zhangjinke/jlink_wifi_v831_hardware/Photos/IMG_20230429_182352.jpg

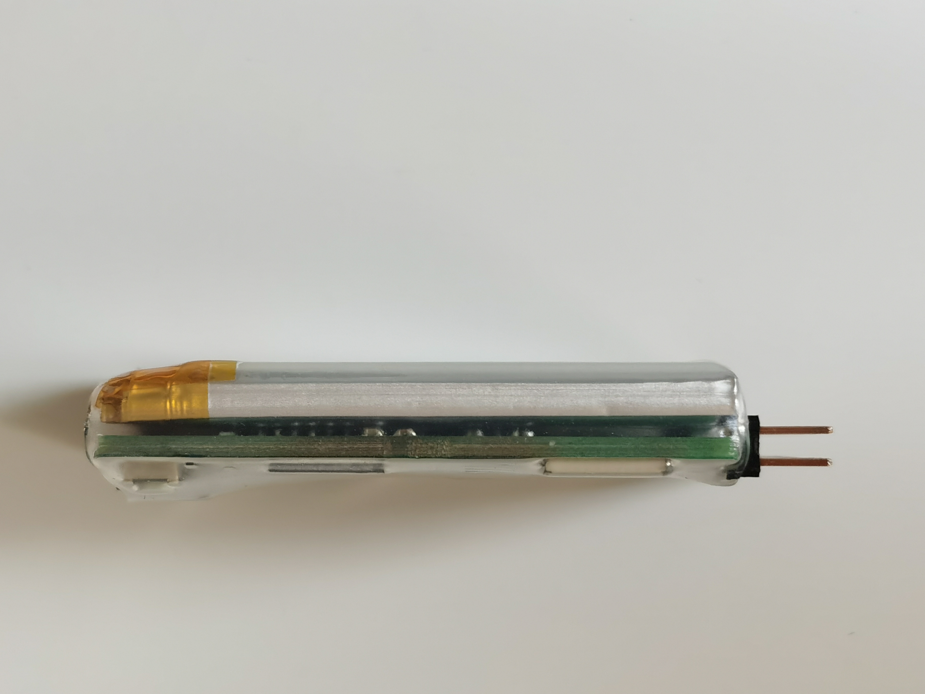
Photos/IMG_20230429_182352.jpg
