zhangjinke/jlink_wifi_v831_hardware/PCB/说明.txt

工程使用嘉立创EDA(专业版)创建

层压顺序：JLC04161H-7628(通用推荐/免费)结构
阻抗管控：+/-20%（免费）
电池型号：053048
热缩管直径：Φ25mm
热缩管长度：54mm
