zhangjinke/jlink_wifi_v831_hardware/PCB/BOM_J-Link_WiFi_072_V831_J-Link_WiFi_072_V831_2023-10-15.xlsx

No. | Quantity | Comment | Designator | Footprint | Value | Manufacturer Part | Manufacturer | Primary Category | Secondary Category | LCSC Price | Price | 总价
1 | 19 | 2.2uF | C1,C2,C5,C6,C7,C8,C9,C10,C11,C12,C23,C27,C35,C36,C37,C40,C41,C42,C50 | C0402 | 2.2uF | CL05A225MQ5NNNC | SAMSUNG(三星) | Capacitors | Multilayer Ceramic Capacitors MLCC - SMD/SMT | 0.027553 | 0.523507 | 83.577195
2 | 5 | 10uF | C3,C4,C22,C34,C45 | C0402 | 10uF | CL05A106MQ5NUNC | SAMSUNG(三星) | Capacitors | Multilayer Ceramic Capacitors MLCC - SMD/SMT | 0.029753 | 0.148765
3 | 15 | 100nF | C13,C24,C28,C29,C30,C32,C33,C52,C53,C57,C58,C59,C60,C61,C62 | C0402 | 100nF | CC0402KRX7R8BB104 | YAGEO(国巨) | Capacitors | Multilayer Ceramic Capacitors MLCC - SMD/SMT | 0.011655 | 0.174825
4 | 4 | 4.7uF | C14,C15,C16,C55 | C0402 | 4.7uF | CL05A475MQ5NRNC | SAMSUNG(三星) | Capacitors,电容 | Multilayer Ceramic Capacitors MLCC - SMD/SMT,贴片电容(MLCC) | 0.021606 | 0.086424
5 | 4 | 22uF | C17,C18,C19,C20 | C0603 | 22uF | CL10A226MQ8NRNE | SAMSUNG(三星) | Capacitors | Multilayer Ceramic Capacitors MLCC - SMD/SMT | 0.065411 | 0.261644
6 | 2 | 20pF | C21,C26 | C0402 | 20pF | CC0402JRNPO9BN200 | YAGEO(国巨) | Capacitors | Multilayer Ceramic Capacitors MLCC - SMD/SMT | 0.006429 | 0.012858
7 | 1 | 10nF | C25 | C0402 | 10nF | CC0402KRX7R9BB103 | YAGEO(国巨) | Capacitors | Multilayer Ceramic Capacitors MLCC - SMD/SMT | 0.005007 | 0.005007
8 | 3 | 1nF | C31,C38,C39 | C0402 | 1nF | CC0402KRX7R7BB102 | YAGEO(国巨) | Capacitors | Multilayer Ceramic Capacitors MLCC - SMD/SMT | 0.006444 | 0.019332
9 | 4 | 470nF | C43,C44,C49,C51 | C0402 | 470nF | CL05A474KP5NNNC | SAMSUNG(三星) | Capacitors | Multilayer Ceramic Capacitors MLCC - SMD/SMT | 0.020612 | 0.082448
10 | 1 | 5.6pF | C46 | C0402 | 5.6pF | CL05C5R6CB5NNNC | SAMSUNG(三星) | 电容 | 贴片电容(MLCC) | 0.024957 | 0.024957
11 | 2 | 1uF | C47,C48 | C0402 | 1uF | CC0402KRX5R5BB105 | YAGEO(国巨) | Capacitors | Multilayer Ceramic Capacitors MLCC - SMD/SMT | 0.014371 | 0.028742
12 | 2 | TBD | C54,C56 | C0402 | TBD
13 | 7 | PESDHC2FD4V5BH | D1,D3,D4,D5,D6,D7,D8 | DFN1006-2L-BI |  | PESDHC2FD4V5BH | Prisemi 芯导 | TVS/Fuse/Board Level Protection | ESD Protection Devices | 0.104758 | 0.733306
14 | 1 | 1N5819WS | D2 | SOD-323_L1.6-W1.3-LS2.6-RD-1 |  | 1N5819WS | GOODWORK(固得沃克) | Diodes | Schottky Barrier Diodes (SBD) | 0.087668 | 0.087668
15 | 4 | 1uH | L1,L2,L3,L4 | IND-SMD_L2.5-W2.0_AHP252010X | 1uH | SWPA252012S1R0MT | Sunlord(顺络) | Inductors/Coils/Transformers | Power Inductors | 0.259522 | 1.038088
16 | 1 | 2.2uH | L5 | IND-SMD_L2.5-W2.0_AHP252010X | 2.2uH | SWPA252010S2R2MT | Sunlord(顺络) | 电感/线圈/变压器 | 功率电感 | 0.245798 | 0.245798
17 | 1 | TBD | L6 | L0201 | TBD
18 | 1 | AN9520-245 | L7 | ANT-SMD_L9.5-W2.1 |  | AN9520-245 | rainsun台湾霖昱微 | Radio Frequency Chip/Antenna | Antennas | 1.8521 | 1.8521
19 | 3 | RED | LED1,LED3,LED4 | LED0402-RD |  | MHT136CRCT | MEIHUA(美华科技) | Optocoupler/LED/Digital Tube/Photoelectric Device | Light Emitting Diodes (LED) | 0.2472 | 0.7416
20 | 1 | GREEN | LED2 | LED0402-RD_GREEN |  | MHT136CGCT | MEIHUA(美华科技) | Optocoupler/LED/Digital Tube/Photoelectric Device | Light Emitting Diodes (LED) | 0.24338 | 0.24338
21 | 1 | WHITE | LED5 | LED0402-RD_WHITE |  | MHT136WDT-C2 | MEIHUA(美华科技) | Optocoupler/LED/Digital Tube/Photoelectric Device | Light Emitting Diodes (LED) | 0.300103 | 0.300103
22 | 1 | BLUE | LED6 | LED0402-RD_BLUE |  | MHT136UBCT | MEIHUA(美华科技) | Optocoupler/LED/Digital Tube/Photoelectric Device | Light Emitting Diodes (LED) | 0.264358 | 0.264358
23 | 1 | YELLOW | LED7 | LED0402-RD_YELLOW |  | MHT136CYCT | MEIHUA(美华科技) | Optocoupler/LED/Digital Tube/Photoelectric Device | Light Emitting Diodes (LED) | 0.268196 | 0.268196
24 | 1 | BAT | P1 | HDR-TH_2P-P1.27-V-M |  | 1.27-1*2P针 | BOOMELE(博穆精密) | Connectors | Pin Headers | 0.108128 | 0.108128
25 | 1 | DEBUG | P2 | HDR-TH_3P-P1.27-V-M-1 |  | 1.27-1*3P针 | BOOMELE(博穆精密) | Connectors | Pin Headers | 0.164047 | 0.164047
26 | 1 | SWD | P3 | HDR-TH_4P-P1.27-V-M |  | DZ127R-11-04-25 | DEALON(德艺隆) | Connectors | Pin Headers | 0.149906 | 0.149906
27 | 1 | PORT | P4 | HDR-SMD_20P-P2.54 |  | B-2100S20P-B110 | Ckmtw(灿科盟) | 连接器 | 排针 | 1.0931 | 1.0931
28 | 3 | 2.2kΩ | R1,R2,R6 | R0402 | 2.2kΩ | 0402WGF2201TCE | UNI-ROYAL(厚声) | Resistors | Chip Resistor - Surface Mount | 0.003099 | 0.009297
29 | 6 | 4.7kΩ | R3,R10,R11,R22,R31,R32 | R0402 | 4.7kΩ | RC0402FR-074K7L | YAGEO(国巨) | Resistors | Chip Resistor - Surface Mount | 0.003681 | 0.022086
30 | 1 | SDNT1608X103F3435FTF | R4 | R0603 |  | SDNT1608X103F3435FTF | Sunlord(顺络) | Sensors | NTC Thermistors | 0.133355 | 0.133355
31 | 2 | 680Ω | R5,R23 | R0402 | 680Ω | 0402WGF6800TCE | UNI-ROYAL(厚声) | Resistors | Chip Resistor - Surface Mount | 0.003059 | 0.006118
32 | 2 | 33Ω | R7,R8 | R0402 | 33Ω | 0402WGF330JTCE | UNI-ROYAL(厚声) | Resistors | Chip Resistor - Surface Mount | 0.003032 | 0.006064
33 | 2 | 0Ω | R9,R12 | R0402 | 0Ω | AC0402FR-070RL | YAGEO(国巨) | Resistors | Chip Resistor - Surface Mount | 0.006307 | 0.012614
34 | 5 | 33kΩ | R13,R14,R15,R16,R17 | R0402 | 33kΩ | 0402WGF3302TCE | UNI-ROYAL(厚声) | 电阻 | 贴片电阻 | 0.003037 | 0.015185
35 | 2 | 5.1kΩ | R18,R20 | R0402 | 5.1kΩ | RC0402FR-075K1L | YAGEO(国巨) | Resistors | Chip Resistor - Surface Mount | 0.003718 | 0.007436
36 | 2 | 100kΩ | R19,R21 | R0402 | 100kΩ | AC0402FR-07100KL | YAGEO(国巨) | Resistors | Chip Resistor - Surface Mount | 0.006564 | 0.013128
37 | 5 | 100Ω | R24,R25,R26,R29,R30 | R0402 | 100Ω | RC0402FR-07100RL | YAGEO(国巨) | Resistors | Chip Resistor - Surface Mount | 0.003753 | 0.018765
38 | 2 | 27Ω | R27,R28 | R0402 | 27Ω | RTT0227R0FTH | RALEC(旺诠) | Resistors | Chip Resistor - Surface Mount | 0.008728 | 0.017456
39 | 2 | KEY | SW1,SW2 | SW-SMD_4P-L4.2-W3.3-P2.15-LS5.1 |  | TS-1089S-AR02516 | XUNPU(讯普) | Key/Switch | Tactile Switches | 0.334518 | 0.669036
40 | 1 | ME6206A33XG | U1 | SOT-23-3_L2.9-W1.6-P1.90-LS2.8-BR |  | ME6206A33XG | MICRONE(南京微盟) | 电源芯片 | 线性稳压器(LDO) | 0.25044 | 0.25044
41 | 1 | AXP2101 | U2 | QFN-40_L5.0-W5.0-P0.40-TL-EP3.4 |  | AXP2101 | Allwinner(全志) | PMIC |  | 5.48 | 5.48
42 | 1 | V831 | U3 | QFN-88_L9.0-W9.0-P0.35-TL-EP6.5 |  | V831 | Allwinner(全志) | MPU |  | 30.44 | 30.44
43 | 1 | CSNP1GCR01-BOW | U4 | LGA-8_L6.0-W8.0-P1.27-TL |  | CSNP1GCR01-BOW | CS(创世) | 存储器 | NAND FLASH | 10.45 | 10.45
44 | 1 | XR829 | U5 | QFN-40_L5.0-W5.0-P0.40-BL-EP3.4 |  | XR829 |  |  |  | 9.98 | 9.98
45 | 1 | SGM7222YMS10/TR | U6 | MSOP-10_L3.0-W3.0-P0.50-LS5.0-BL |  | SGM7222YMS10/TR | SGMICRO(圣邦微) | Communication Interface Chip/UART/485/232 | Analog Switches / Multiplexers | 5.36 | 5.36
46 | 1 | SMD0805B050TF | U7 | F0805 |  | SMD0805B050TF | Brightking(君耀电子) | TVS/保险丝/板级保护 | 自恢复保险丝 | 0.117108 | 0.117108
47 | 1 | SM05.TCT | U8 | SOT-23-3_L2.9-W1.3-P1.90-LS2.4 |  | SM05.TCT | UMW(友台半导体) | TVS/Fuse/Board Level Protection | ESD Protection Devices | 0.570952 | 0.570952
48 | 1 | MF-NSMF200-2 | U9 | F1206 |  | MF-NSMF200-2 | BOURNS | TVS/Fuse/Board Level Protection | Resettable Fuses | 0.165263 | 0.165263
49 | 1 | STM32F072CBT6 | U10 | LQFP-48_L7.0-W7.0-P0.50-LS9.0-BL |  | STM32F072CBT6 | ST(意法半导体) | Single Chip Microcomputer/Microcontroller | ST Microelectronics | 10.16 | 10.16
50 | 1 | KH-TYPE-C-16P | USB1 | USB-C-SMD_KH-TYPE-C-16P |  | KH-TYPE-C-16P | kinghelm(金航标) | Connectors | USB Connectors | 0.511 | 0.511
51 | 1 | 24MHz | X1 | CRYSTAL-SMD_4P-L2.0-W1.6-BL | 24MHz | X201624MKB4SI | YXC(扬兴科技) | Crystal Oscillator/Oscillator/Resonator | Crystals | 0.503605 | 0.503605
