zhangjinke/jlink_wifi_v831_hardware/PCB/SCH_J-Link_WiFi_072_V831_2023-09-08.pdf

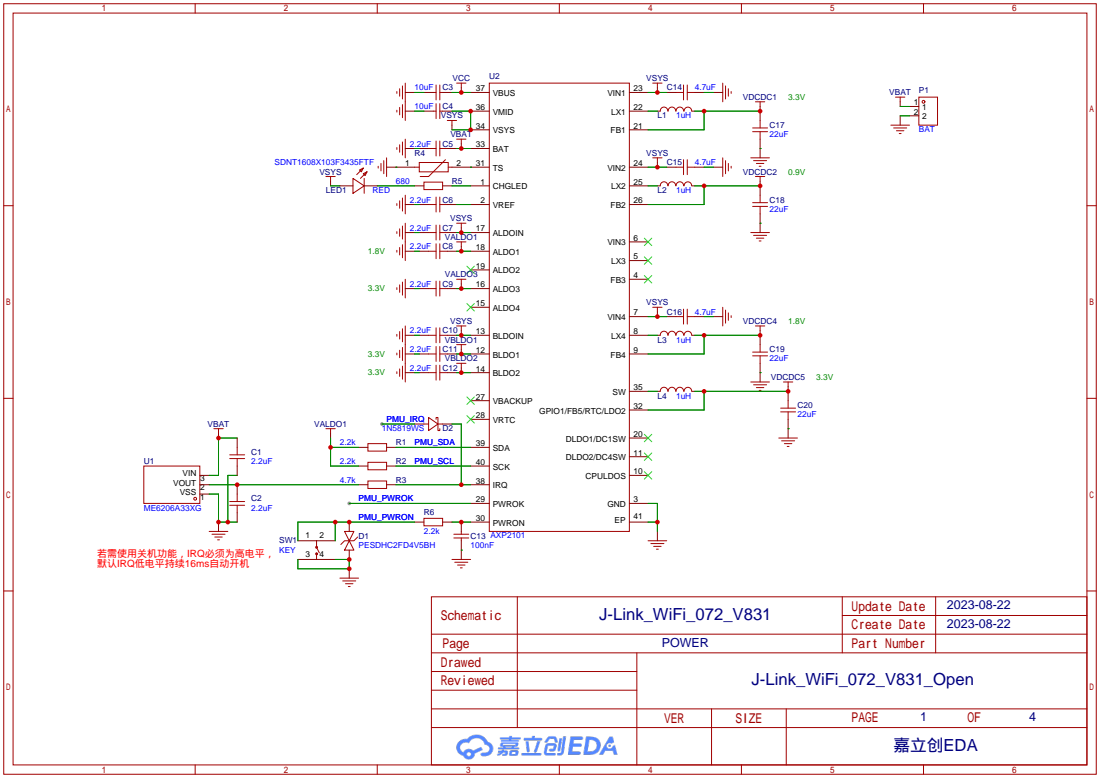
[picture p4: page 1]

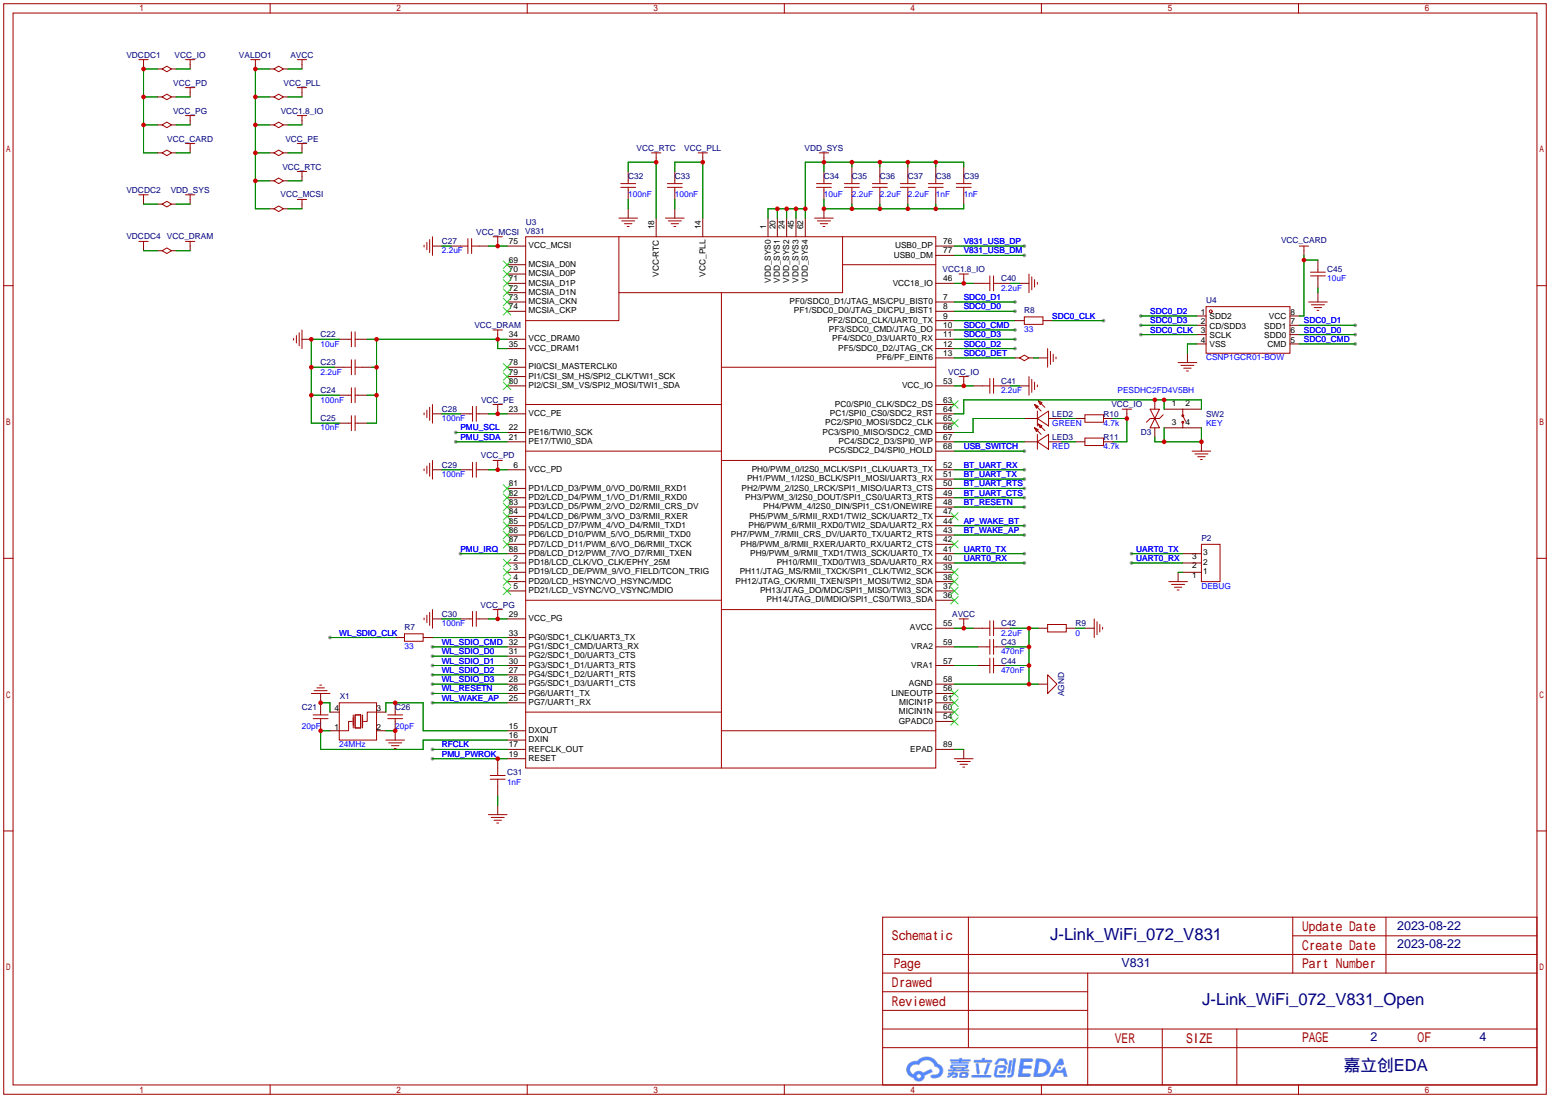
[picture p5: page 2]

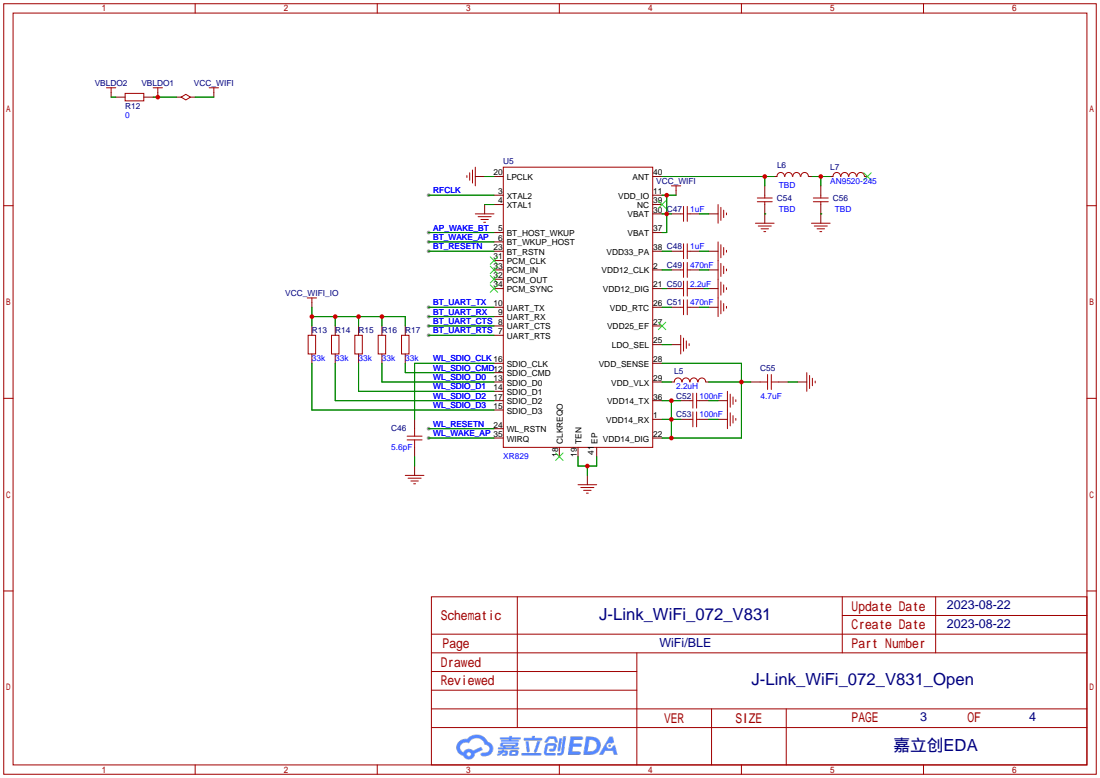
[picture p6: page 3]

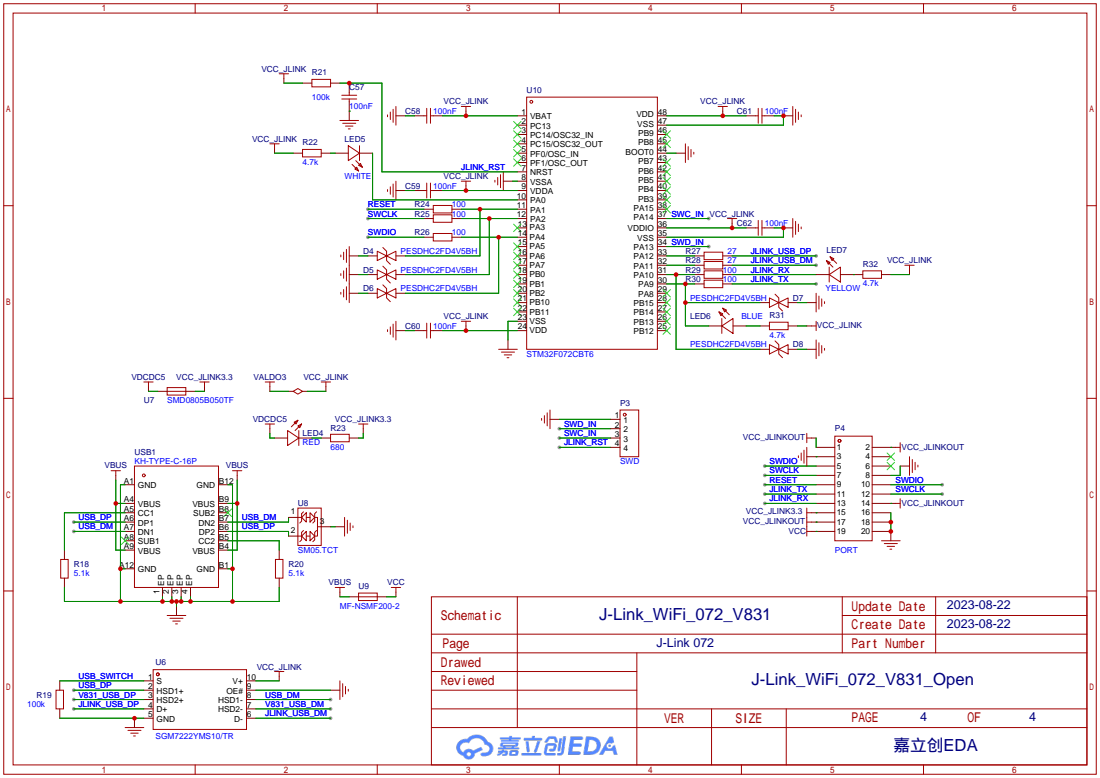
[picture p7: page 4]
