zhangjinke/jlink_wifi_v831_hardware/(list of files, drawings)

Other design files:
PCB/ProProject_J-Link_WiFi_072_V831_Open_2023-09-08.epro
