zhangjinke/jlink_wifi_v831_hardware/(commit log)

2023-10-06 1. 更新APP为1.2.1； 2. 增加升级文件及升级说明；
2023-10-15 1. 增加BOM表； 2. 增加热缩管长度说明； 3. 调整目录名大小写；
    [BOM_J-Link_WiFi_072_V831_J-Link_WiFi_072_V831_2023-10-15.xlsx, ProProject_J-Link_WiFi_072_V831_Open_2023-09-08.epro]
2023-10-15 增加C2000相关说明
2023-10-15 增加J-Link参数说明、WEB说明
2023-10-19 1. 增加J-Link OB-STM32F072-128KB-CortexM固件与描述； 2. 序列号烧写方法中增加序列号范围描述。
2023-11-08 修正AP模式WiFi密码描述错误的问题
2023-12-04 增加层压顺序、阻抗管控说明
2024-12-08 增加固件J-Link OB-STM32F072-128KB-CortexM 20231030.bin
